X-shadows12/cloud_terrace/Hardware/GD32电控.pdf

## VBAT: 7~26V

## VBAT: 7~26V

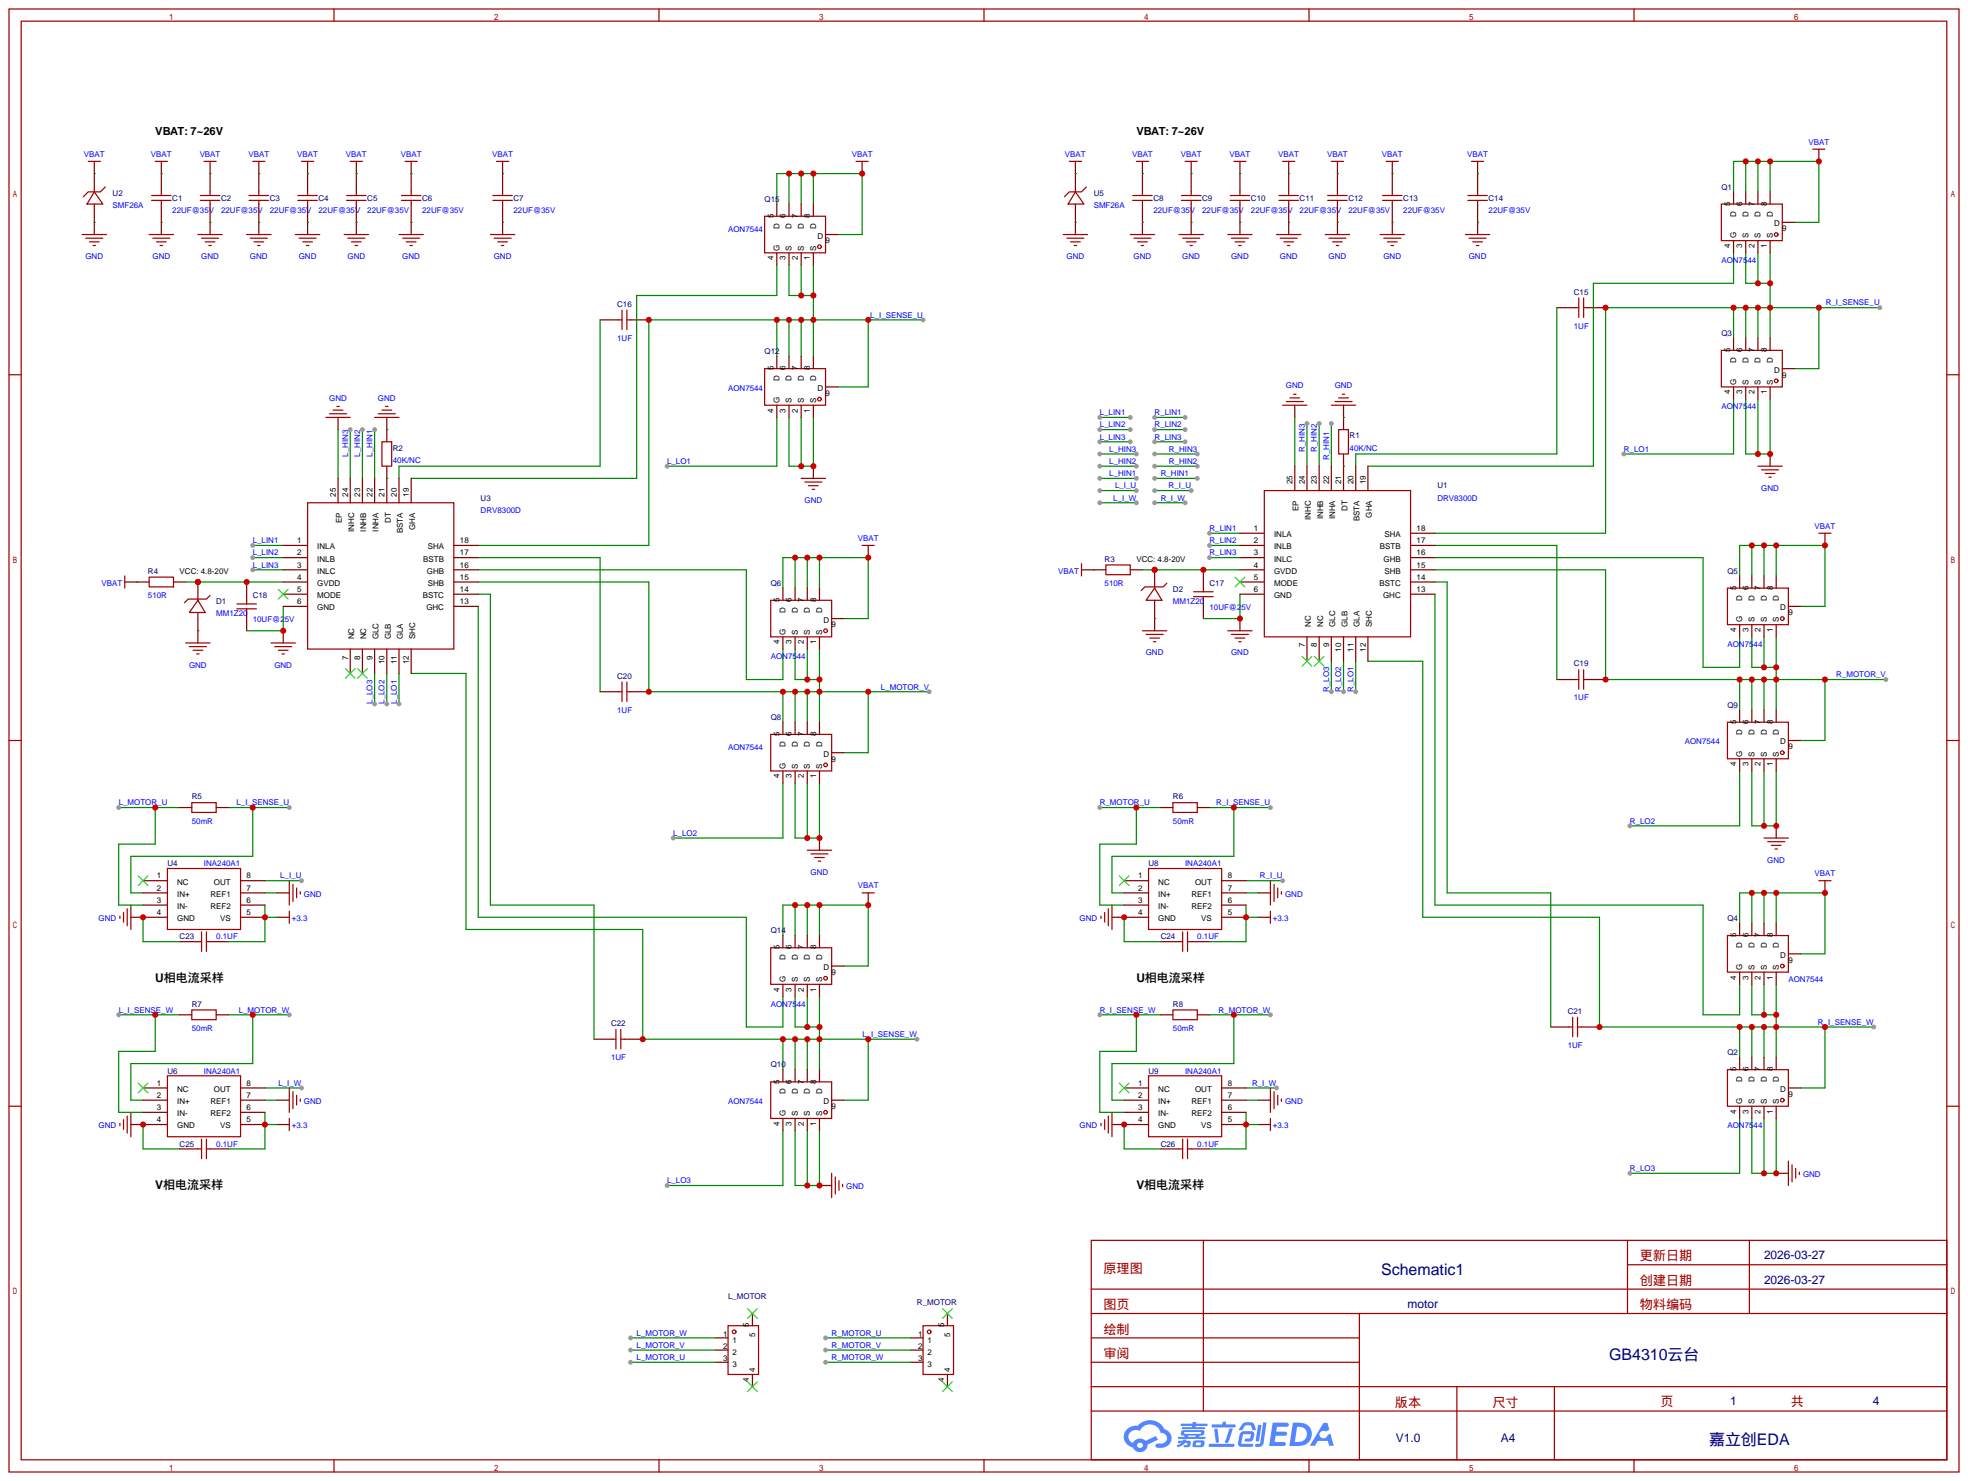
[picture p19: page 1]

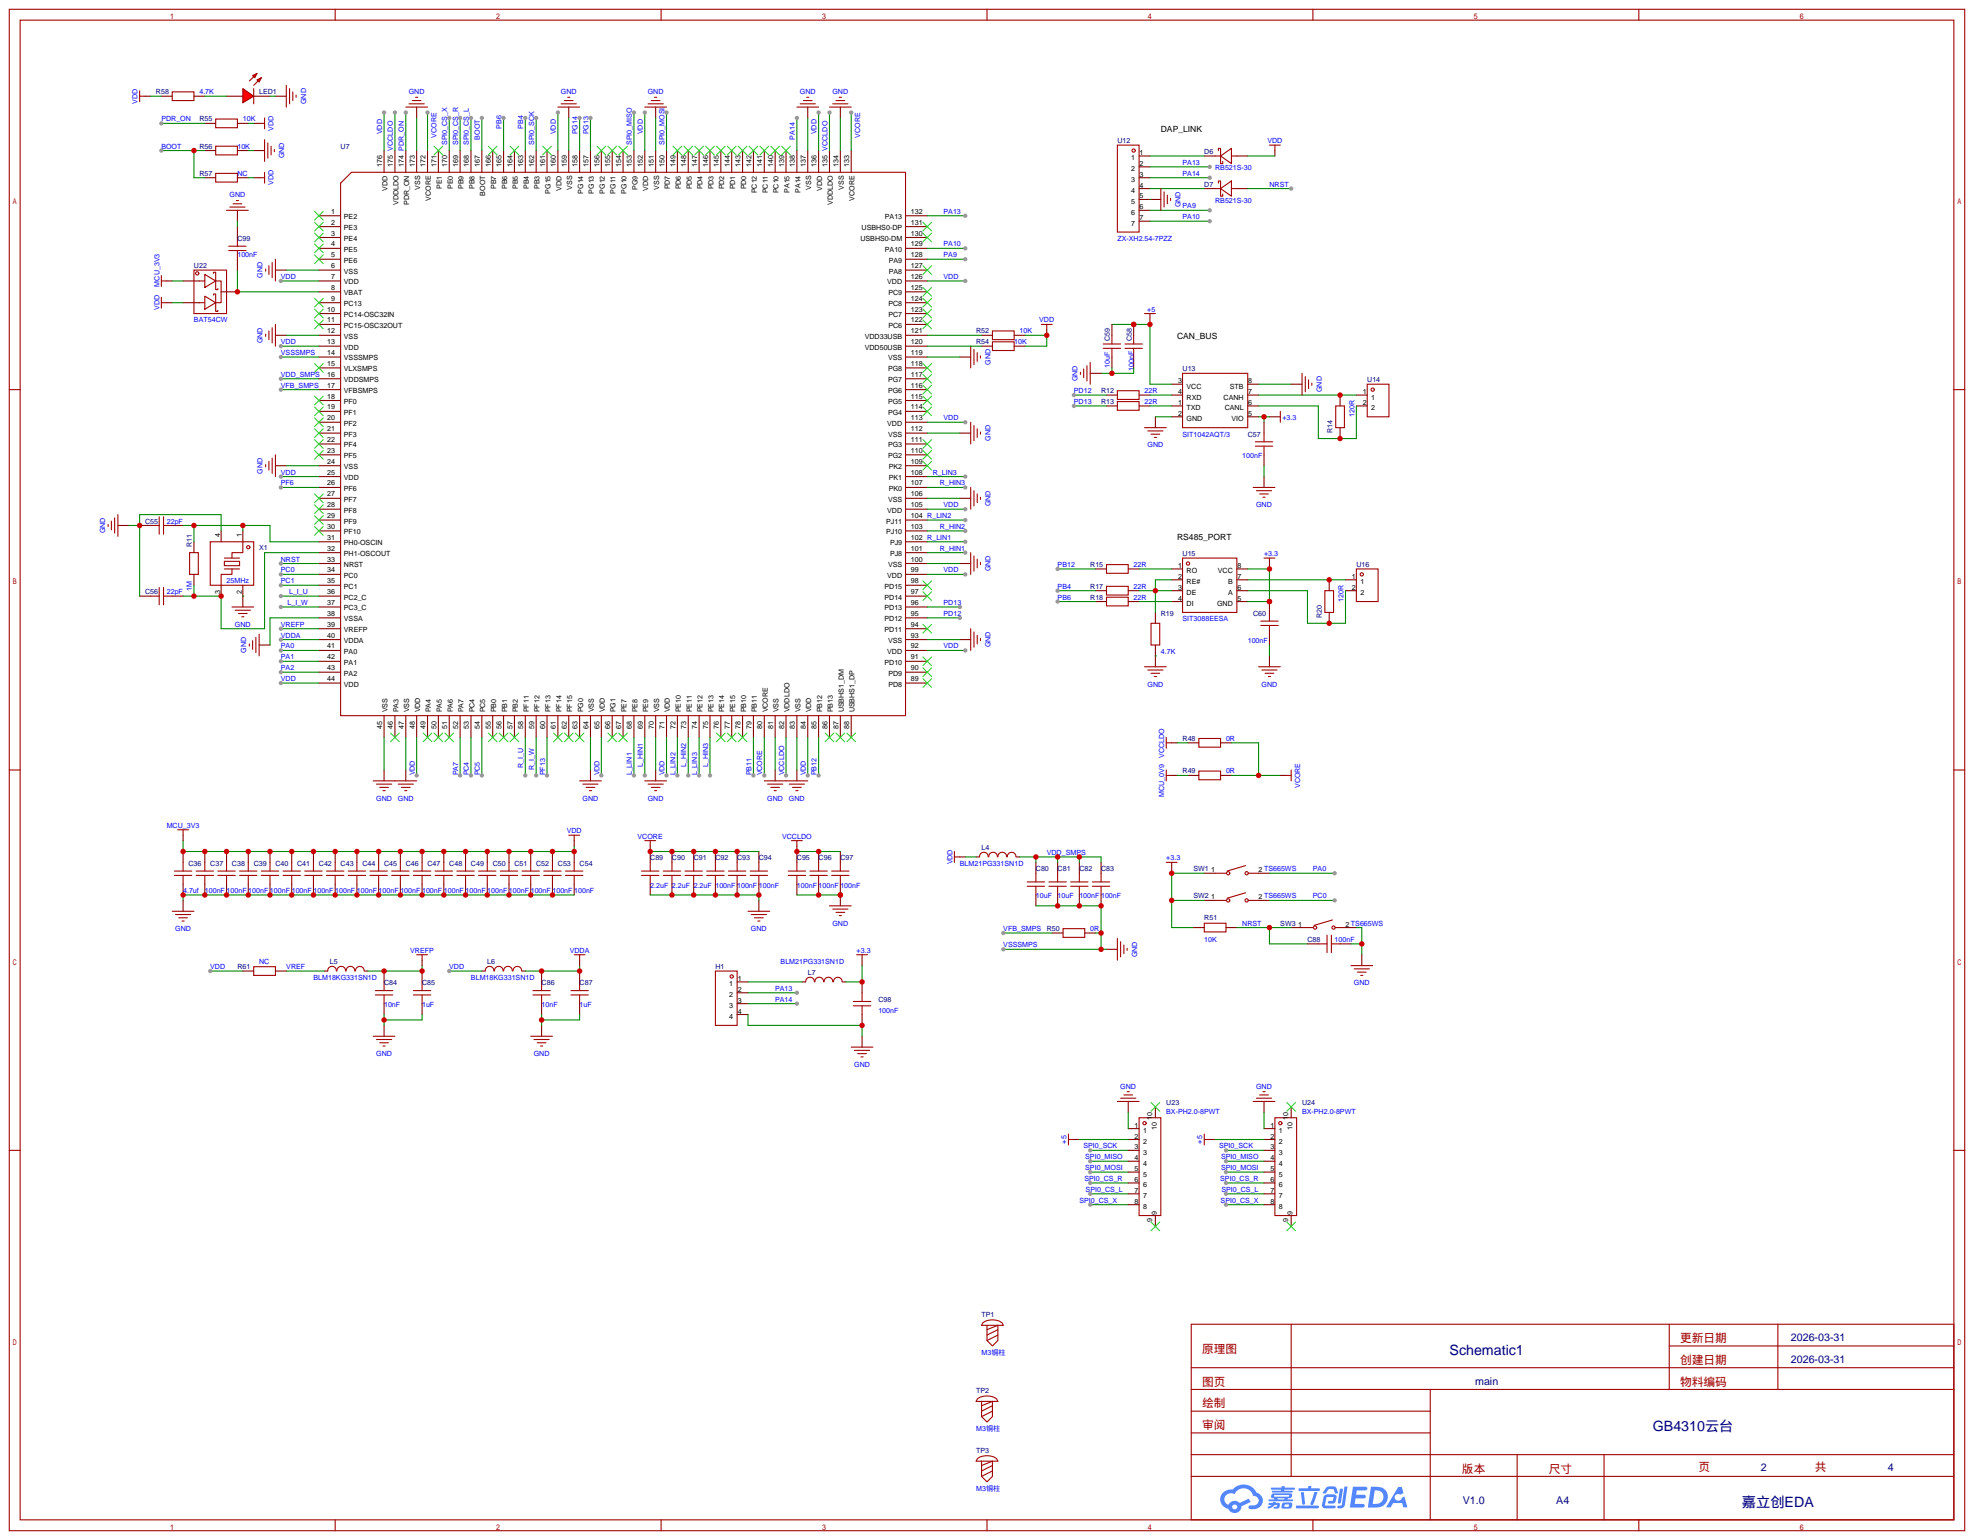
[picture p20: page 2]

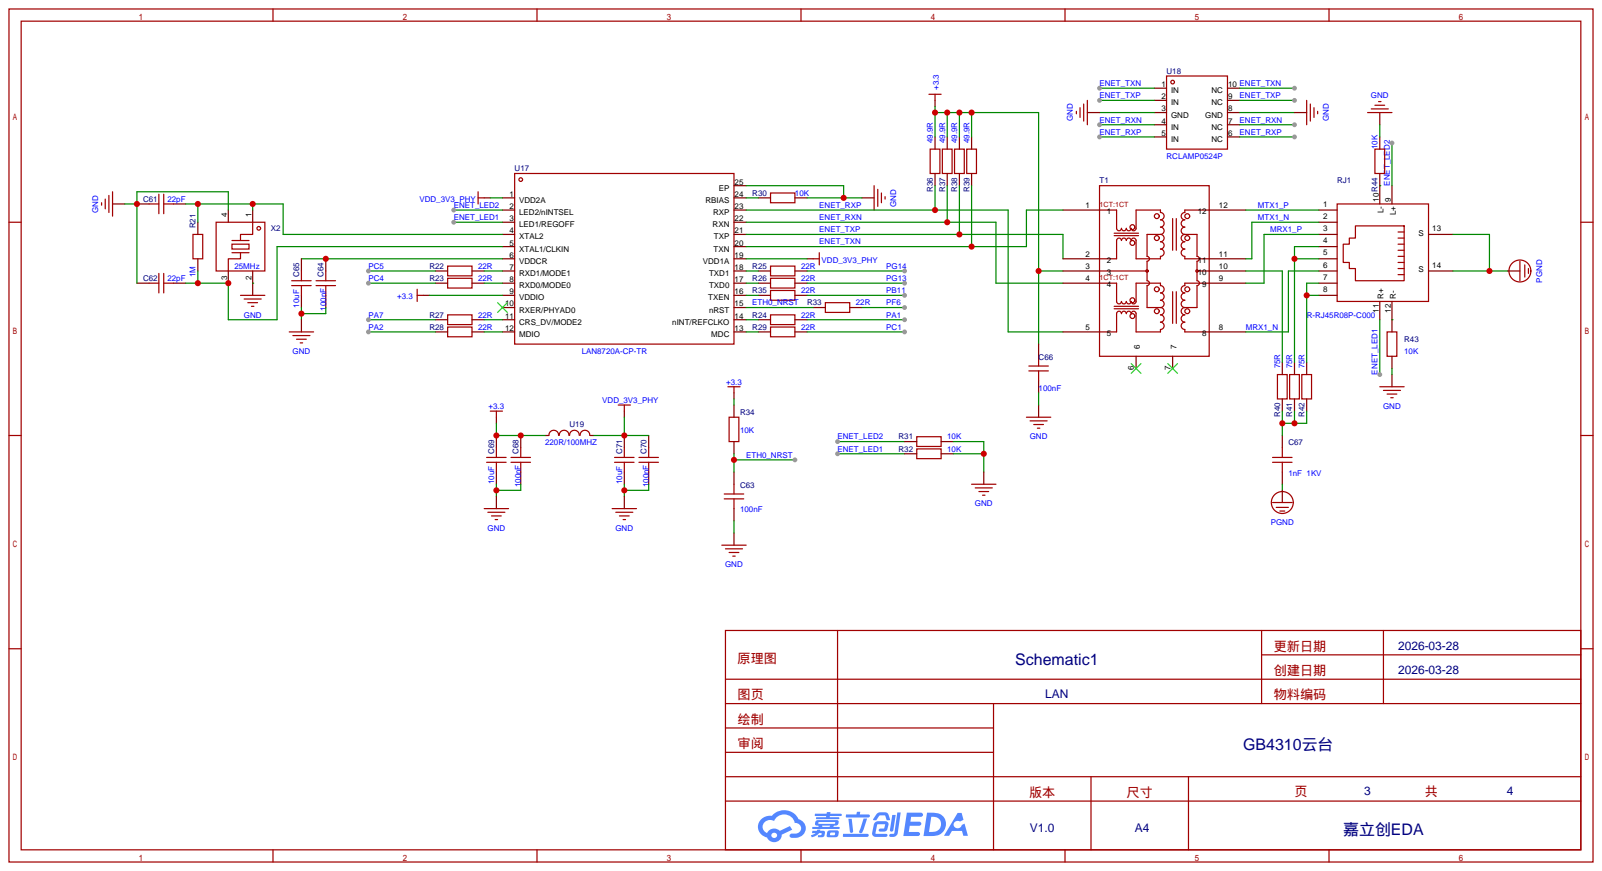
[picture p21: page 3]

# R45 100K VBAT +3.3

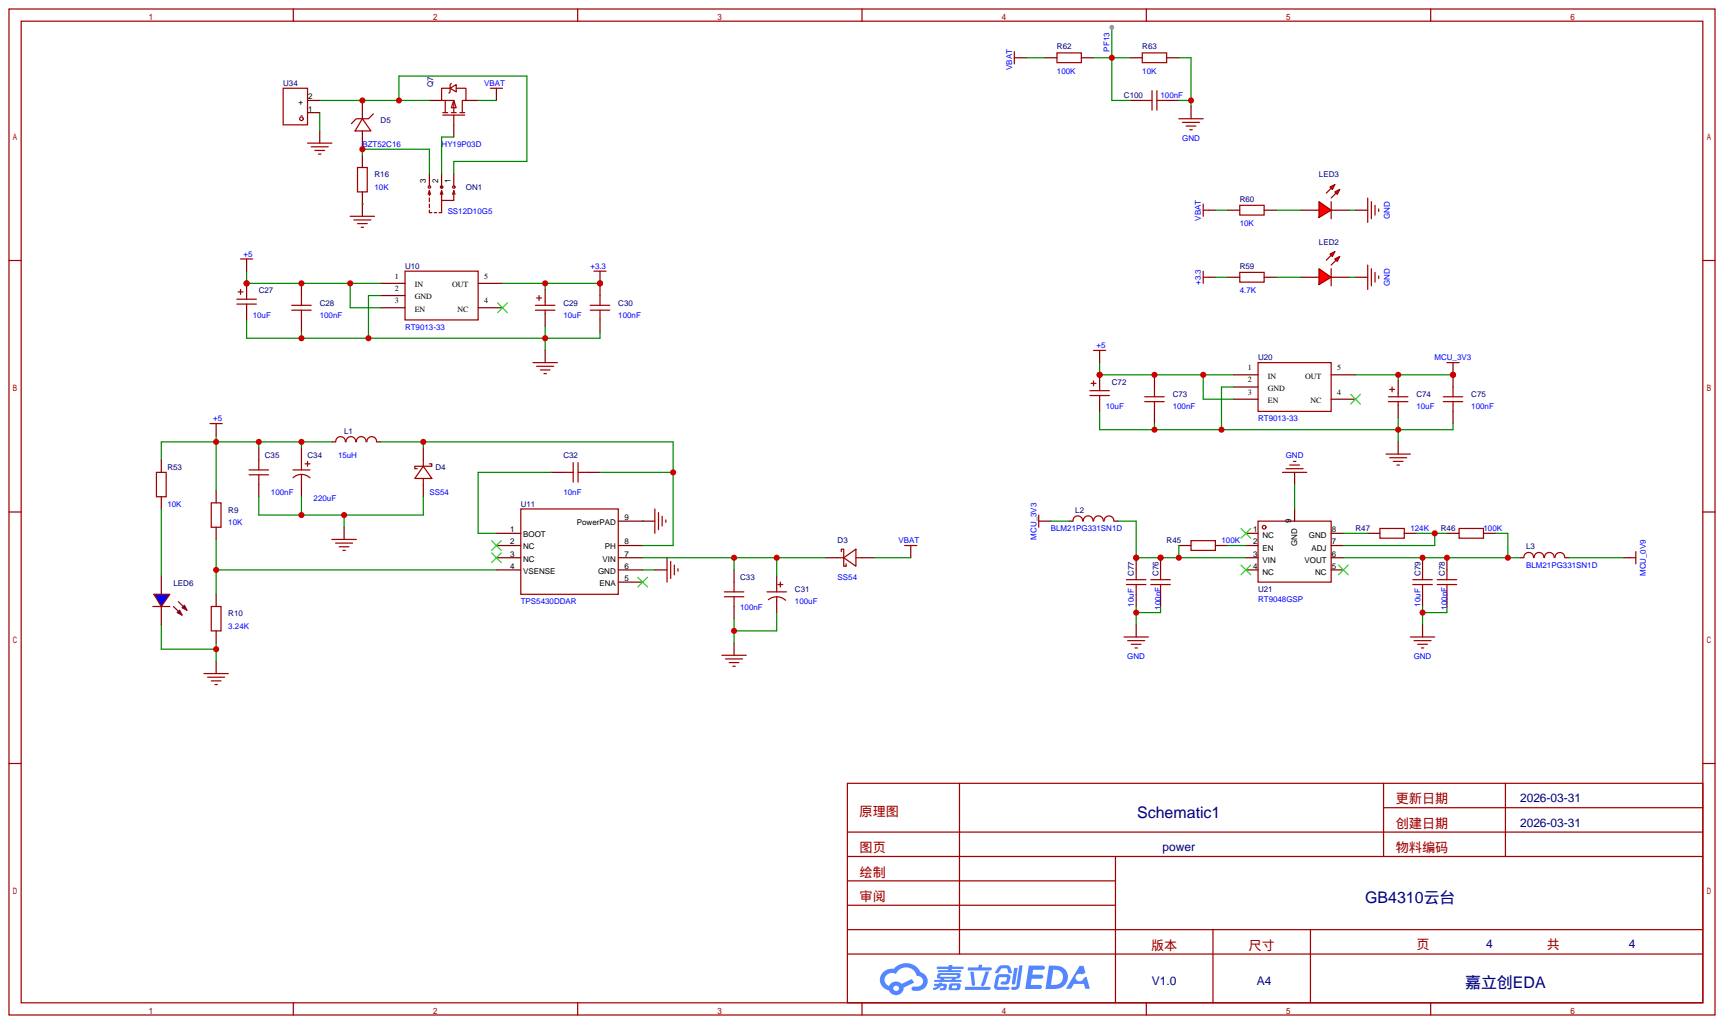
[picture p22: page 4]
