X-shadows12/cloud_terrace/Firmware/Firmware_app/Source/gd32h7xx_it.h

/*
    Copyright 2021 codenocold codenocold@qq.com
    Address : https://github.com/codenocold/ctm
    This file is part of the ctm firmware.
*/

#ifndef GD32H7XX_IT_H
#define GD32H7XX_IT_H

#include "gd32h7xx.h"
#include "board_port.h"
#include "main.h"

void NMI_Handler(void);
void HardFault_Handler(void);
void MemManage_Handler(void);
void BusFault_Handler(void);
void UsageFault_Handler(void);
void SVC_Handler(void);
void DebugMon_Handler(void);
void PendSV_Handler(void);
#if BOARD_ENABLE_DUAL_MOTOR_CONTROL
void BOARD_LEFT_PHASE_ADC_IRQHandler(void);
void BOARD_RIGHT_PHASE_ADC_IRQHandler(void);
#else
void BOARD_PHASE_ADC_IRQHandler(void);
#endif
void BOARD_SYSTEM_TIMER_IRQHandler(void);
#if (BOARD_ENCODER_INTERFACE == BOARD_ENCODER_IF_PWM)
void TIMER3_IRQHandler(void);
#endif
void BOARD_CAN_IRQHandler(void);

#endif /* GD32H7XX_IT_H */
