X-shadows12/cloud_terrace/Firmware/Firmware_app/Source/gd32h7xx_libopt.h

/*!
    \file    gd32h7xx_libopt.h
    \brief   GD32H7xx standard peripheral headers used by this firmware
*/

#ifndef GD32H7XX_LIBOPT_H
#define GD32H7XX_LIBOPT_H

#include "gd32h7xx_adc.h"
#include "gd32h7xx_can.h"
#include "gd32h7xx_dbg.h"
#include "gd32h7xx_dma.h"
#include "gd32h7xx_fmc.h"
#include "gd32h7xx_fwdgt.h"
#include "gd32h7xx_gpio.h"
#include "gd32h7xx_misc.h"
#include "gd32h7xx_pmu.h"
#include "gd32h7xx_rcu.h"
#include "gd32h7xx_spi.h"
#include "gd32h7xx_syscfg.h"
#include "gd32h7xx_timer.h"
#include "gd32h7xx_trigsel.h"

#endif /* GD32H7XX_LIBOPT_H */
