X-shadows12/cloud_terrace/Firmware/Firmware_app/Source/util.c

/*
    Copyright 2021 codenocold codenocold@qq.com
    Address : https://github.com/codenocold/ctm
    This file is part of the ctm firmware.
    The ctm firmware is free software: you can redistribute it and/or modify
    it under the terms of the GNU General Public License as published by
    the Free Software Foundation, either version 3 of the License, or
    (at your option) any later version.
    The ctm firmware is distributed in the hope that it will be useful,
    but WITHOUT ANY WARRANTY; without even the implied warranty of
    MERCHANTABILITY or FITNESS FOR A PARTICULAR PURPOSE.  See the
    GNU General Public License for more details.
    You should have received a copy of the GNU General Public License
    along with this program.  If not, see <http://www.gnu.org/licenses/>.
*/

#include "util.h"
#include <math.h>

#define SIN_TABLE_SIZE 512

static const float sinTable_f32[SIN_TABLE_SIZE + 1]
    = {0.00000000f,  0.01227154f,  0.02454123f,  0.03680722f,  0.04906767f,  0.06132074f,  0.07356456f,  0.08579731f,
       0.09801714f,  0.11022221f,  0.12241068f,  0.13458071f,  0.14673047f,  0.15885814f,  0.17096189f,  0.18303989f,
       0.19509032f,  0.20711138f,  0.21910124f,  0.23105811f,  0.24298018f,  0.25486566f,  0.26671276f,  0.27851969f,
       0.29028468f,  0.30200595f,  0.31368174f,  0.32531029f,  0.33688985f,  0.34841868f,  0.35989504f,  0.37131719f,
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
       0x65c52d24, 0x119b4be9, 0x155a565e, 0x18197087, 0x1cd86d30, 0x029f3d35, 0x065e2082, 0x0b1d065b, 0x0fdc1bec,
       0x3793a651, 0x3352bbe6, 0x3e119d3f, 0x3ad08088, 0x2497d08d, 0x2056cd3a, 0x2d15ebe3, 0x29d4f654, 0xc5a92679,
       0xc1683bce, 0xcc2b1d17, 0xc8ea00a0, 0xd6ad50a5, 0xd26c4d12, 0xdf2f6bcb, 0xdbee767c, 0xe3a1cbc1, 0xe760d676,
       0xea23f0af, 0xeee2ed18, 0xf0a5bd1d, 0xf464a0aa, 0xf9278673, 0xfde69bc4, 0x89b8fd09, 0x8d79e0be, 0x803ac667,
       0x84fbdbd0, 0x9abc8bd5, 0x9e7d9662, 0x933eb0bb, 0x97ffad0c, 0xafb010b1, 0xab710d06, 0xa6322bdf, 0xa2f33668,
       0xbcb4666d, 0xb8757bda, 0xb5365d03, 0xb1f740b4};

void clarke_transform(float Ia, float Ib, float Ic, float *Ialpha, float *Ibeta)
{
    *Ialpha = Ia;
    *Ibeta  = (Ib - Ic) * ONE_BY_SQRT3;
}

void park_transform(float Ialpha, float Ibeta, float Theta, float *Id, float *Iq)
{
    float s = sin_f32(Theta);
    float c = cos_f32(Theta);
    *Id     = Ialpha * c + Ibeta * s;
    *Iq     = -Ialpha * s + Ibeta * c;
}

void inverse_park(float mod_d, float mod_q, float Theta, float *mod_alpha, float *mod_beta)
{
    float s    = sin_f32(Theta);
    float c    = cos_f32(Theta);
    *mod_alpha = mod_d * c - mod_q * s;
    *mod_beta  = mod_d * s + mod_q * c;
}

/// @brief svpwm modulate
/// @param alpha Input   [-1~+1]
/// @param alpha Input   [-1~+1]
/// @param duty_a Output [0~1]
/// @param duty_b Output [0~1]
/// @param duty_c Output [0~1]
int svm(float alpha, float beta, float *duty_a, float *duty_b, float *duty_c)
{
    int Sextant;

    if (beta >= 0.0f) {
        if (alpha >= 0.0f) {
            //quadrant I
            if (ONE_BY_SQRT3 * beta > alpha)
                Sextant = 2; //sextant v2-v3
            else
                Sextant = 1; //sextant v1-v2

        } else {
            //quadrant II
            if (-ONE_BY_SQRT3 * beta > alpha)
                Sextant = 3; //sextant v3-v4
            else
                Sextant = 2; //sextant v2-v3
        }
    } else {
        if (alpha >= 0.0f) {
            //quadrant IV
            if (-ONE_BY_SQRT3 * beta > alpha)
                Sextant = 5; //sextant v5-v6
            else
                Sextant = 6; //sextant v6-v1
        } else {
            //quadrant III
            if (ONE_BY_SQRT3 * beta > alpha)
                Sextant = 4; //sextant v4-v5
            else
                Sextant = 5; //sextant v5-v6
        }
    }

    switch (Sextant) {
    // sextant v1-v2
    case 1: {
        // Vector on-times
        float t1 = alpha - ONE_BY_SQRT3 * beta;
        float t2 = TWO_BY_SQRT3 * beta;

        // PWM timings
        *duty_a = (1.0f - t1 - t2) * 0.5f;
        *duty_b = *duty_a + t1;
        *duty_c = *duty_b + t2;
    } break;

    // sextant v2-v3
    case 2: {
        // Vector on-times
        float t2 = alpha + ONE_BY_SQRT3 * beta;
        float t3 = -alpha + ONE_BY_SQRT3 * beta;

        // PWM timings
        *duty_b = (1.0f - t2 - t3) * 0.5f;
        *duty_a = *duty_b + t3;
        *duty_c = *duty_a + t2;
    } break;

    // sextant v3-v4
    case 3: {
        // Vector on-times
        float t3 = TWO_BY_SQRT3 * beta;
        float t4 = -alpha - ONE_BY_SQRT3 * beta;

        // PWM timings
        *duty_b = (1.0f - t3 - t4) * 0.5f;
        *duty_c = *duty_b + t3;
        *duty_a = *duty_c + t4;
    } break;

    // sextant v4-v5
    case 4: {
        // Vector on-times
        float t4 = -alpha + ONE_BY_SQRT3 * beta;
        float t5 = -TWO_BY_SQRT3 * beta;

        // PWM timings
        *duty_c = (1.0f - t4 - t5) * 0.5f;
        *duty_b = *duty_c + t5;
        *duty_a = *duty_b + t4;
    } break;

    // sextant v5-v6
    case 5: {
        // Vector on-times
        float t5 = -alpha - ONE_BY_SQRT3 * beta;
        float t6 = alpha - ONE_BY_SQRT3 * beta;

        // PWM timings
        *duty_c = (1.0f - t5 - t6) * 0.5f;
        *duty_a = *duty_c + t5;
        *duty_b = *duty_a + t6;
    } break;

    // sextant v6-v1
    case 6: {
        // Vector on-times
        float t6 = -TWO_BY_SQRT3 * beta;
        float t1 = alpha + ONE_BY_SQRT3 * beta;

        // PWM timings
        *duty_a = (1.0f - t6 - t1) * 0.5f;
        *duty_c = *duty_a + t1;
        *duty_b = *duty_c + t6;
    } break;
    }

    // if any of the results becomes NaN, result_valid will evaluate to false
    int result_valid = *duty_a >= 0.0f && *duty_a <= 1.0f && *duty_b >= 0.0f && *duty_b <= 1.0f && *duty_c >= 0.0f
                       && *duty_c <= 1.0f;

    return result_valid ? 0 : -1;
}

float sin_f32(float x)
{
    float    sinVal, fract, in; /* Temporary variables for input, output */
    uint16_t index;             /* Index variable */
    float    a, b;              /* Two nearest output values */
    int32_t  n;
    float    findex;

    /* input x is in radians */
    /* Scale the input to [0 1] range from [0 2*PI] , divide input by 2*pi */
    in = x * 0.159154943092f;

    /* Calculation of floor value of input */
    n = (int32_t) in;

    /* Make negative values towards -infinity */
    if (x < 0.0f) {
        n--;
    }

    /* Map input value to [0 1] */
    in = in - (float) n;

    /* Calculation of index of the table */
    findex = (float) SIN_TABLE_SIZE * in;
    index  = (uint16_t) findex;

    /* when "in" is exactly 1, we need to rotate the index down to 0 */
    if (index >= SIN_TABLE_SIZE) {
        index = 0;
        findex -= (float) SIN_TABLE_SIZE;
    }

    /* fractional value calculation */
    fract = findex - (float) index;

    /* Read two nearest values of input value from the sin table */
    a = sinTable_f32[index];
    b = sinTable_f32[index + 1];

    /* Linear interpolation process */
    sinVal = (1.0f - fract) * a + fract * b;

    /* Return the output value */
    return (sinVal);
}

float cos_f32(float x)
{
    float    cosVal, fract, in; /* Temporary variables for input, output */
    uint16_t index;             /* Index variable */
    float    a, b;              /* Two nearest output values */
    int32_t  n;
    float    findex;

    /* input x is in radians */
    /* Scale the input to [0 1] range from [0 2*PI] , divide input by 2*pi, add 0.25 (pi/2) to read sine table */
    in = x * 0.159154943092f + 0.25f;

    /* Calculation of floor value of input */
    n = (int32_t) in;

    /* Make negative values towards -infinity */
    if (in < 0.0f) {
        n--;
    }

    /* Map input value to [0 1] */
    in = in - (float) n;

    /* Calculation of index of the table */
    findex = (float) SIN_TABLE_SIZE * in;
    index  = (uint16_t) findex;

    /* when "in" is exactly 1, we need to rotate the index down to 0 */
    if (index >= SIN_TABLE_SIZE) {
        index = 0;
        findex -= (float) SIN_TABLE_SIZE;
    }

    /* fractional value calculation */
    fract = findex - (float) index;

    /* Read two nearest values of input value from the cos table */
    a = sinTable_f32[index];
    b = sinTable_f32[index + 1];

    /* Linear interpolation process */
    cosVal = (1.0f - fract) * a + fract * b;

    /* Return the output value */
    return (cosVal);
}

uint32_t crc32(const uint8_t *data, uint32_t size)
{
    uint32_t crc = 0;
    for (uint32_t i = 0; i < size; ++i) {
        crc = (crc << 8) ^ crc32_table[((crc >> 24) ^ data[i]) & 0xFF];
    }
    return crc;
}

int uint32_to_data(uint32_t val, uint8_t *data)
{
    data[0] = *(((uint8_t *) (&val)) + 0);
    data[1] = *(((uint8_t *) (&val)) + 1);
    data[2] = *(((uint8_t *) (&val)) + 2);
    data[3] = *(((uint8_t *) (&val)) + 3);
    return 4;
}

int int32_to_data(int32_t val, uint8_t *data)
{
    data[0] = *(((uint8_t *) (&val)) + 0);
    data[1] = *(((uint8_t *) (&val)) + 1);
    data[2] = *(((uint8_t *) (&val)) + 2);
    data[3] = *(((uint8_t *) (&val)) + 3);
    return 4;
}

int uint16_to_data(uint16_t val, uint8_t *data)
{
    data[0] = *(((uint8_t *) (&val)) + 0);
    data[1] = *(((uint8_t *) (&val)) + 1);
    return 2;
}

int int16_to_data(int16_t val, uint8_t *data)
{
    data[0] = *(((uint8_t *) (&val)) + 0);
    data[1] = *(((uint8_t *) (&val)) + 1);
    return 2;
}

int float_to_data(float val, uint8_t *data)
{
    data[0] = *(((uint8_t *) (&val)) + 0);
    data[1] = *(((uint8_t *) (&val)) + 1);
    data[2] = *(((uint8_t *) (&val)) + 2);
    data[3] = *(((uint8_t *) (&val)) + 3);
    return 4;
}

uint32_t data_to_uint32(uint8_t *data)
{
    uint32_t tmp;
    *(((uint8_t *) (&tmp)) + 0) = data[0];
    *(((uint8_t *) (&tmp)) + 1) = data[1];
    *(((uint8_t *) (&tmp)) + 2) = data[2];
    *(((uint8_t *) (&tmp)) + 3) = data[3];
    return tmp;
}

int32_t data_to_int32(uint8_t *data)
{
    int32_t tmp;
    *(((uint8_t *) (&tmp)) + 0) = data[0];
    *(((uint8_t *) (&tmp)) + 1) = data[1];
    *(((uint8_t *) (&tmp)) + 2) = data[2];
    *(((uint8_t *) (&tmp)) + 3) = data[3];
    return tmp;
}

uint16_t data_to_uint16(uint8_t *data)
{
    uint16_t tmp;
    *(((uint8_t *) (&tmp)) + 0) = data[0];
    *(((uint8_t *) (&tmp)) + 1) = data[1];
    return tmp;
}

int16_t data_to_int16(uint8_t *data)
{
    int16_t tmp;
    *(((uint8_t *) (&tmp)) + 0) = data[0];
    *(((uint8_t *) (&tmp)) + 1) = data[1];
    return tmp;
}

float data_to_float(uint8_t *data)
{
    float tmp_float;
    *(((uint8_t *) (&tmp_float)) + 0) = data[0];
    *(((uint8_t *) (&tmp_float)) + 1) = data[1];
    *(((uint8_t *) (&tmp_float)) + 2) = data[2];
    *(((uint8_t *) (&tmp_float)) + 3) = data[3];
    return tmp_float;
}
