X-shadows12/cloud_terrace/Firmware/Firmware_boot/Source/gd32h7xx_it.c

/*
    Copyright 2021 codenocold codenocold@qq.com
    Address : https://github.com/codenocold/ctm
    This file is part of the ctm firmware.
*/

#include "gd32h7xx_it.h"

void NMI_Handler(void)
{
    while (1) {
    }
}

void HardFault_Handler(void)
{
    while (1) {
    }
}

void MemManage_Handler(void)
{
    while (1) {
    }
}

void BusFault_Handler(void)
{
    while (1) {
    }
}

void UsageFault_Handler(void)
{
    while (1) {
    }
}

void SVC_Handler(void)
{
    while (1) {
    }
}

void DebugMon_Handler(void)
{
    while (1) {
    }
}

void PendSV_Handler(void)
{
    while (1) {
    }
}
