X-shadows12/cloud_terrace/Firmware/Firmware_boot/Source/gd32h7xx_libopt.h

/*!
    \file    gd32h7xx_libopt.h
    \brief   GD32H7xx standard peripheral headers used by the bootloader
*/

#ifndef GD32H7XX_LIBOPT_H
#define GD32H7XX_LIBOPT_H

#include "gd32h7xx_fmc.h"
#include "gd32h7xx_fwdgt.h"
#include "gd32h7xx_misc.h"
#include "gd32h7xx_pmu.h"
#include "gd32h7xx_rcu.h"
#include "gd32h7xx_syscfg.h"

#endif /* GD32H7XX_LIBOPT_H */
