X-shadows12/cloud_terrace/(commit log)

2026-05-06 GD32H759平台移植
2026-05-18 电流环参数自整定修改
2026-06-03 双电机控制
2026-06-03 增加调试校准接口
2026-06-06 双电机控制 APP1.0
